Zyad1999/8-bit-RISC-Processor/README.md

# 8-bit-RISC-Processor

Implementation of 8-BIT RISC Processor of the design in (Design Implemented) file.
You can use Assmebler to generate code and upload it to the Memory of the CPU and execute it.
A demo of the project can be found here (https://youtu.be/A1Wd6_hKkDk)
