Zyad1999/8-bit-RISC-Processor/Instructions Provided.jpg

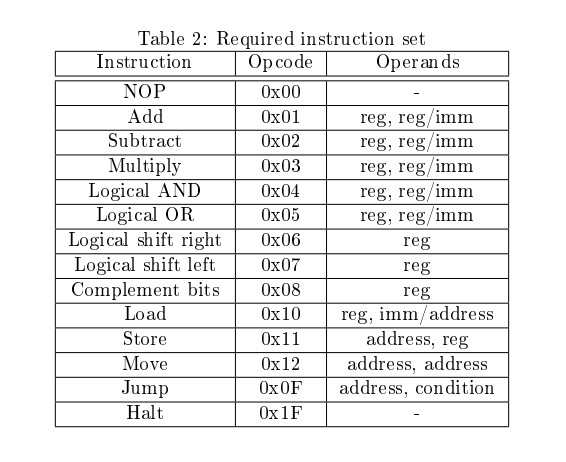
Instructions Provided.jpg
