Zyad1999/8-bit-RISC-Processor/(list of files, drawings)

Other design files:
Modules/AddressMux.circ
Modules/ALU.circ
Modules/CPU.circ
Modules/CU_TRANSLATOR.circ
Modules/Datapath.circ
Modules/General-purpose Register Block.circ
Modules/Generic 16-bit Register.circ
Modules/latch.circ
Modules/Main.circ
Modules/MEMORY_IO.circ
Modules/PC Register.circ
Modules/RAM.circ
Modules/STATE_MACHINE.circ
